prime6cs/big-6502-computer/Schematics/main_build.pdf

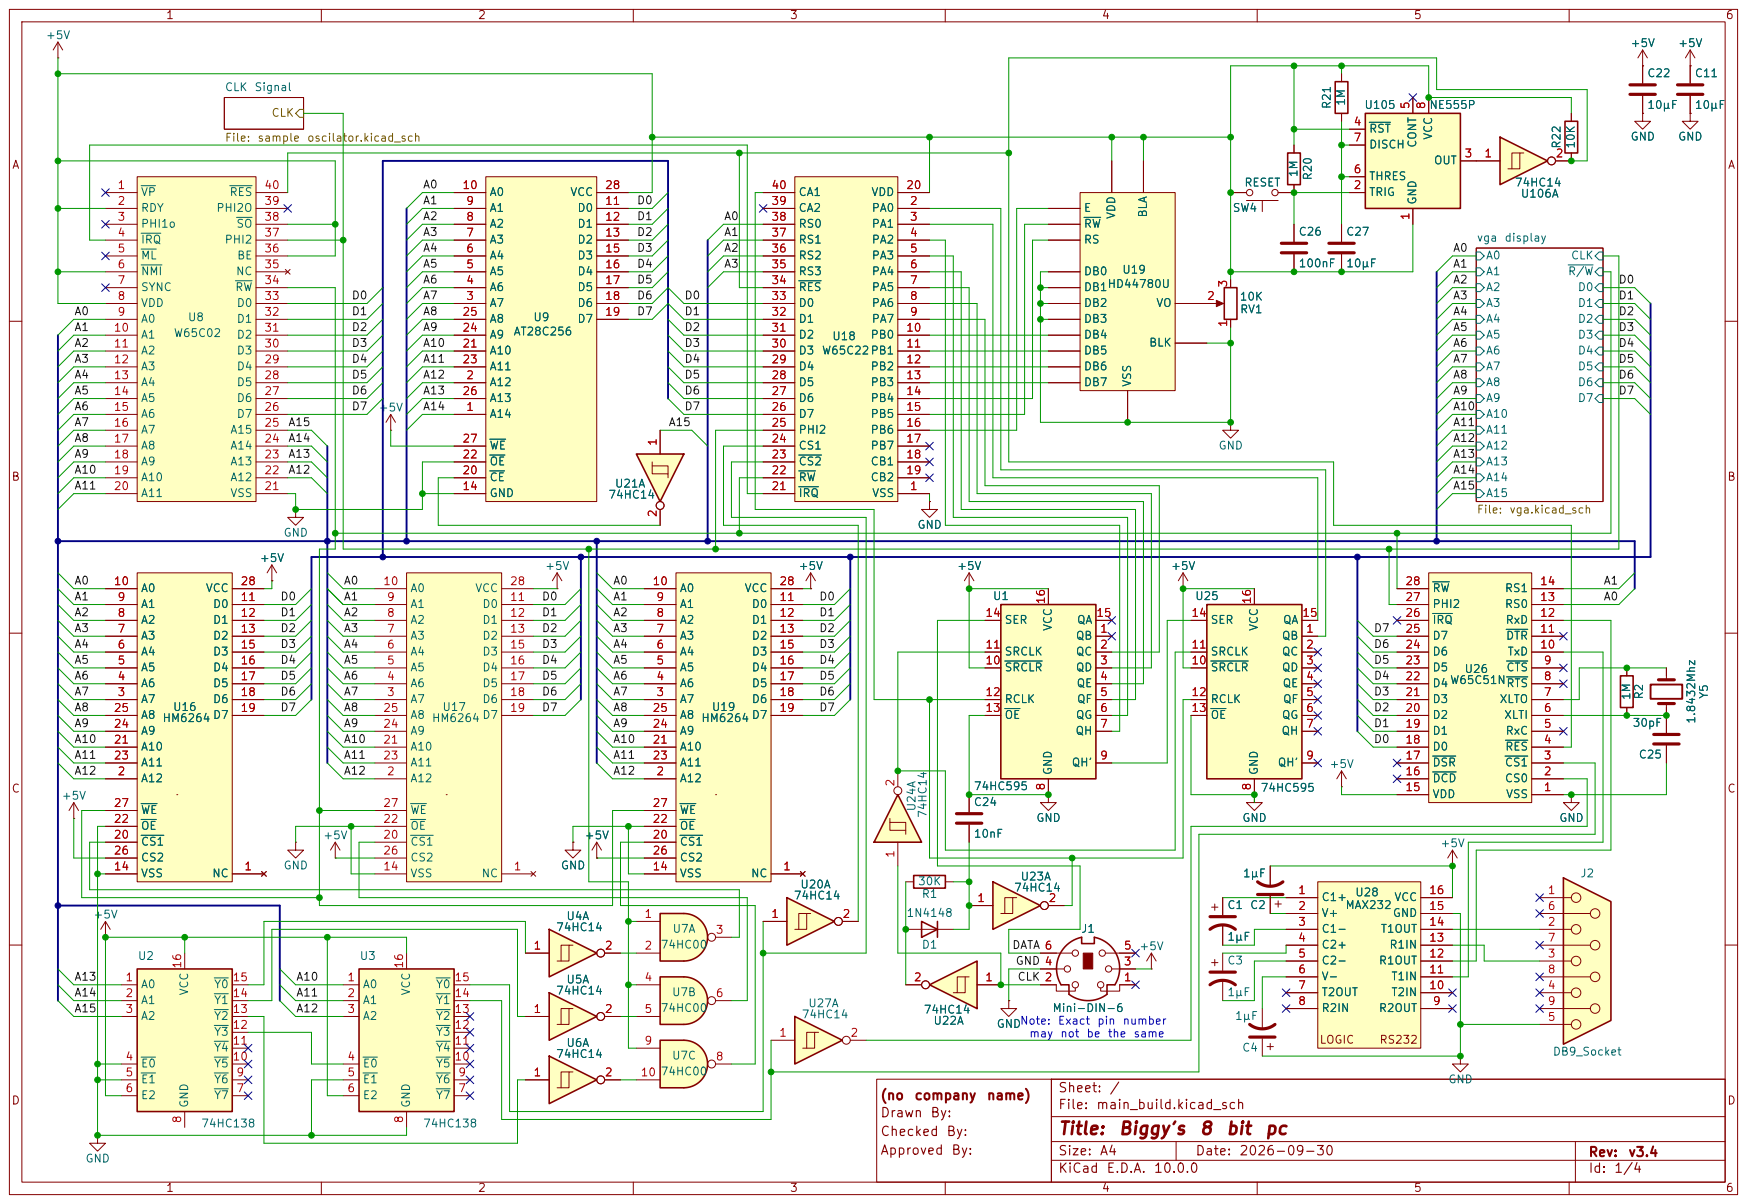
[picture p3: page 1]

Sheet: /
D Date: 2026-09-30 KiCad E.D.A. 10.0.0
File: main_build.kicad_sch
Title: Biggy's 8 bit pc

Size: A4 | Rev: v3.4
