prime6cs/big-6502-computer/Schematics/main_build-CLK Signal.pdf

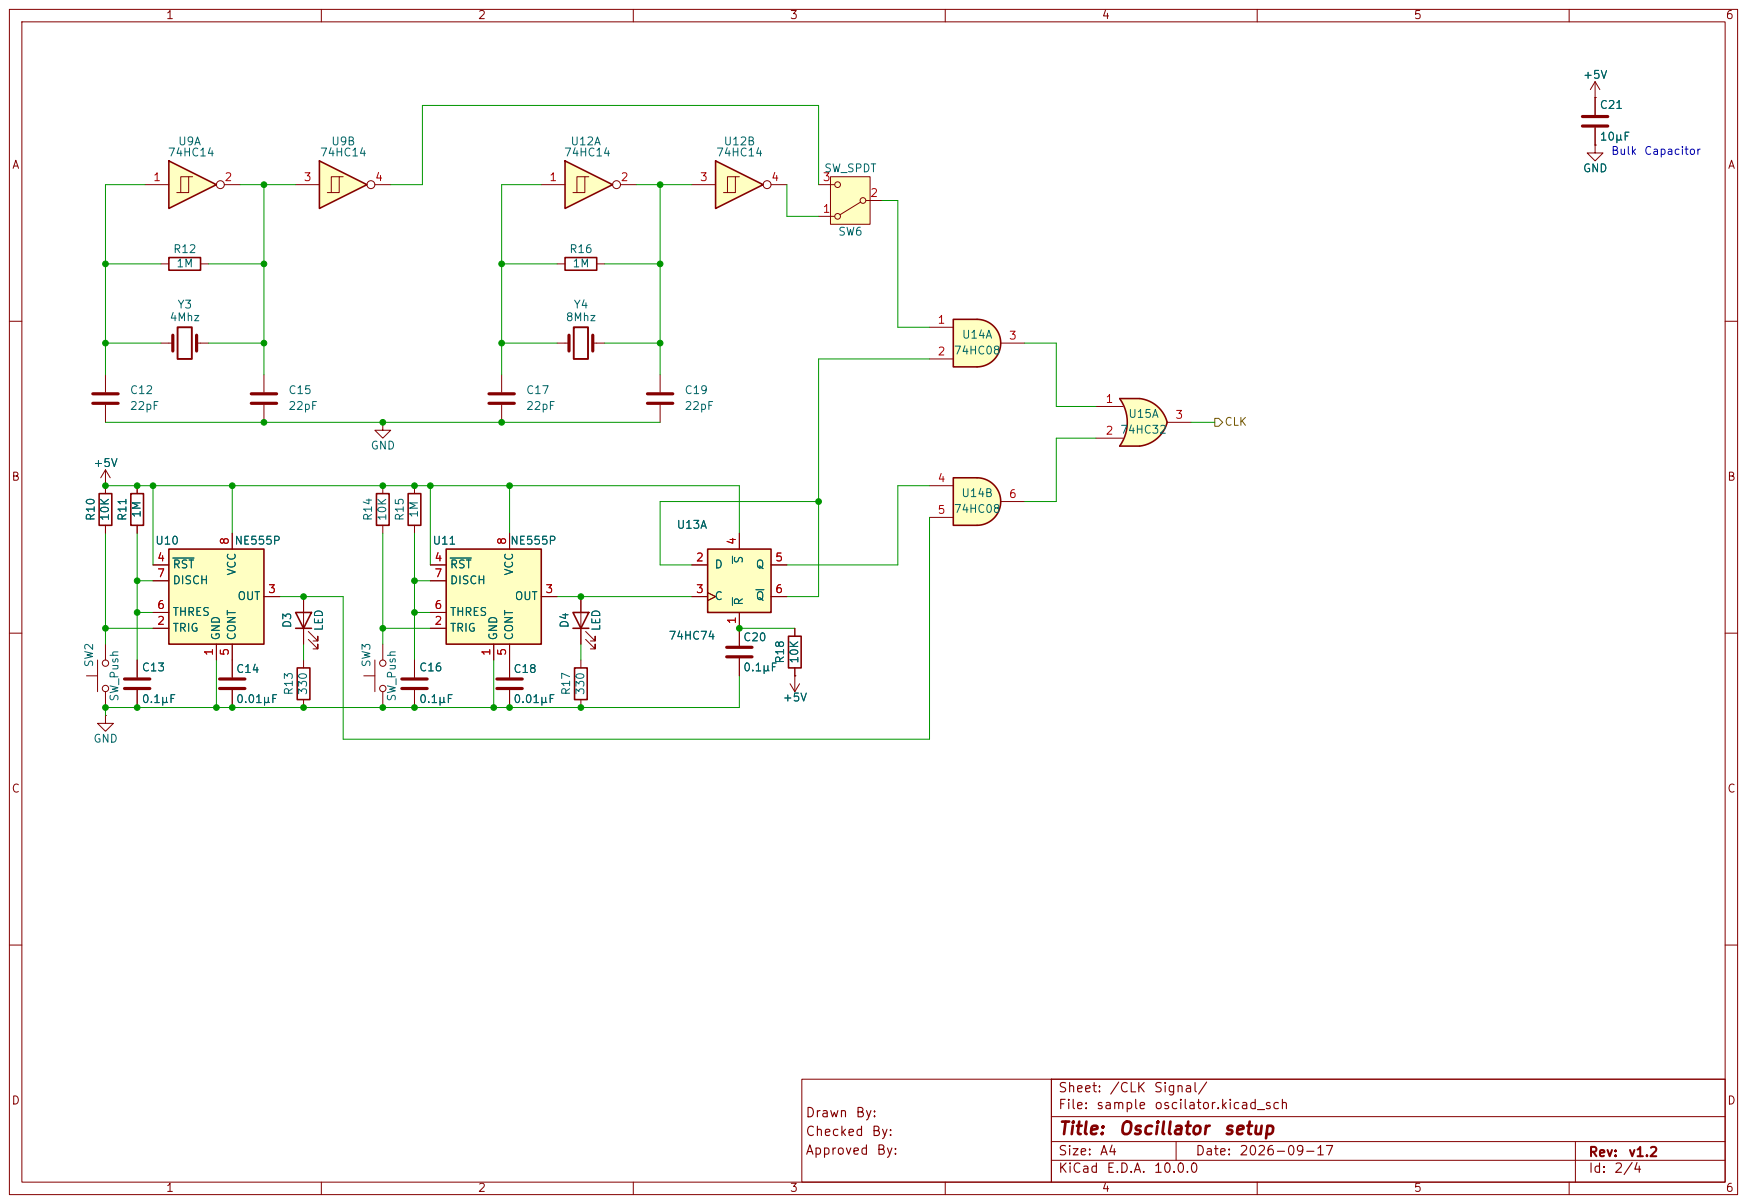
[picture p4: page 1]

Size: A4 | Rev: v1.2
