prime6cs/big-6502-computer/Schematics/main_build-CLK Signal_page-0001.jpg

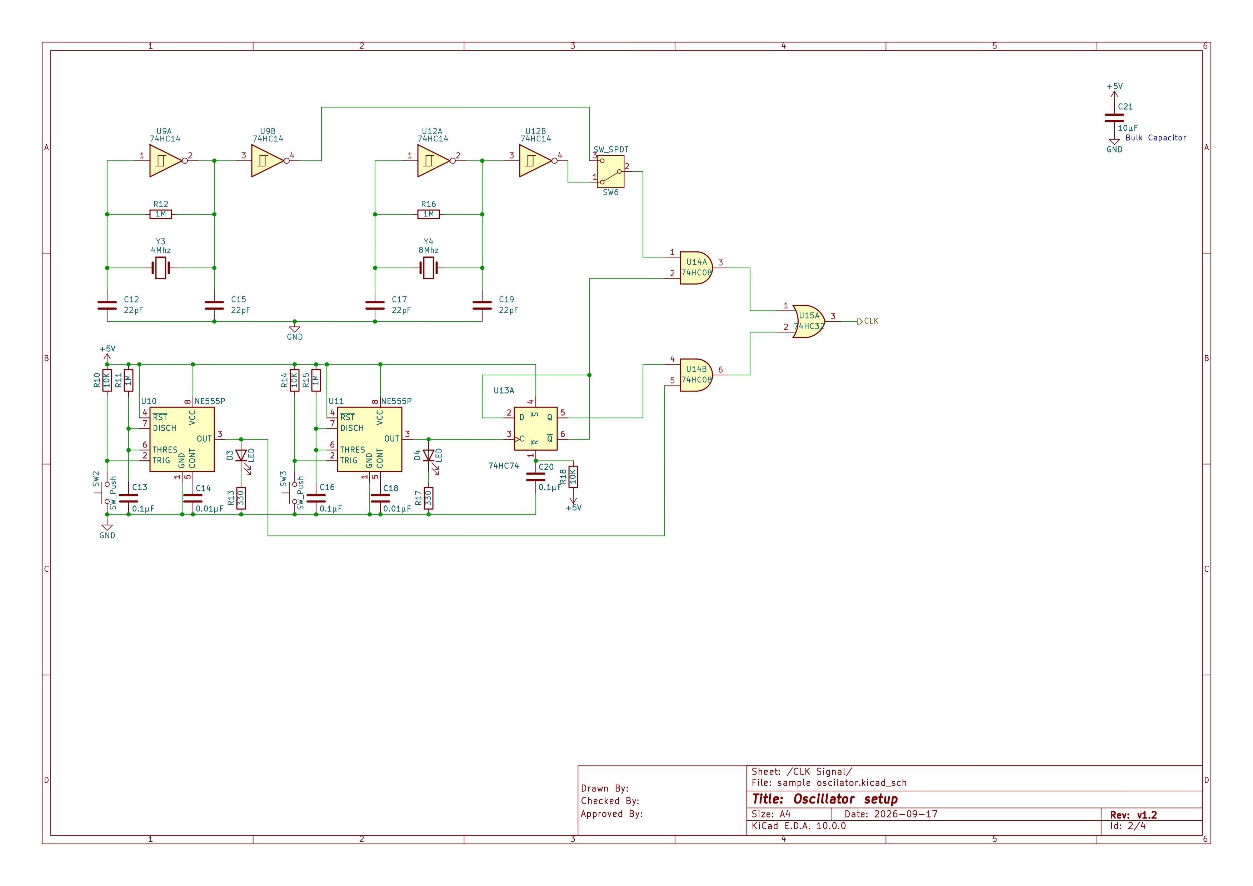
Schematics/main_build-CLK Signal_page-0001.jpg
