prime6cs/big-6502-computer/(commit log)

2026-10-20 Added arduino code essentials
2026-10-28 Added main build schematics and updated README.md
